Ardakaniz/BFComputer/architecture/architecture.jpg

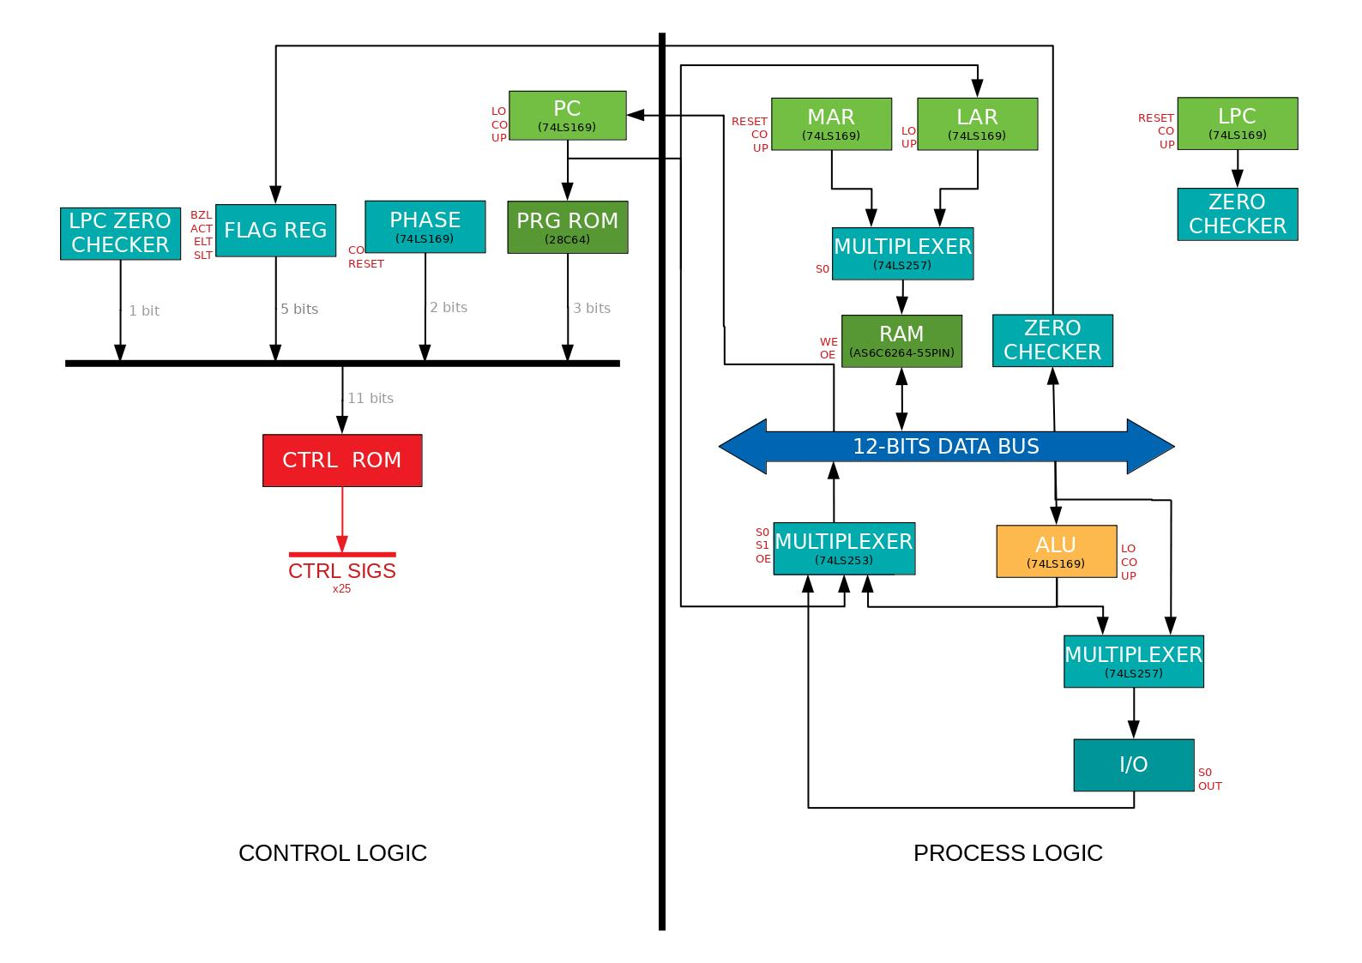
architecture/architecture.jpg
