Ardakaniz/BFComputer/architecture/BOM.ods

BFCom | Composant | Ref. composant | Site d’achat | Nombre | Prix unitaire | Prix total
 | Oscillateur 4MHz | SG-531P 4.0000MC | Mouser | 1 | 1,94 € | 1,94 € | Prix total : | 52,30 €
 | Oscillateur 10MHz | SG-531P 10.0000MC | Mouser | 1 | 1,94 € | 1,94 €
 | ROM 8k x 8 | 28C64 | Mouser | 8 | 2,81 € | 22,48 €
 | RAM 8k x 8 | AS6C6264-55PIN | Mouser | 4 | 2,50 € | 10,00 €
 | Timer 555 | NE555 | Mouser | 2 | 0,47 € | 0,94 €
 | Breadbord ? |  |  | 1 | 15,00 € | 15,00 €
 |  |  |  |  |  | 0,00 €
 |  |  |  |  |  | 0,00 €
 |  |  |  |  |  | 0,00 €
 |  |  |  |  |  | 0,00 €
 |  |  |  |  |  | 0,00 €
 |  |  |  |  |  | 0,00 €
 |  |  |  |  |  | 0,00 €
 |  |  |  |  |  | 0,00 €
 |  |  |  |  |  | 0,00 €
 |  |  |  |  |  | 0,00 €
 |  |  |  |  |  | 0,00 €
 |  |  |  |  |  | 0,00 €
 |  |  |  |  |  | 0,00 €
 |  |  |  |  |  | 0,00 €
 |  |  |  |  |  | 0,00 €
 |  |  |  |  |  | 0,00 €
 |  |  |  |  |  | 0,00 €
 |  |  |  |  |  | 0,00 €
 |  |  |  |  |  | 0,00 €
 |  |  |  |  |  | 0,00 €
 |  |  |  |  |  | 0,00 €
 |  |  |  |  |  | 0,00 €
 |  |  |  |  |  | 0,00 €
 |  |  |  |  |  | 0,00 €
 |  |  |  |  |  | 0,00 €
 |  |  |  |  |  | 0,00 €
 |  |  |  |  |  | 0,00 €
 |  |  |  |  |  | 0,00 €
 |  |  |  |  |  | 0,00 €
 |  |  |  |  |  | 0,00 €
 |  |  |  |  |  | 0,00 €
 |  |  |  |  |  | 0,00 €
 |  |  |  |  |  | 0,00 €
 |  |  |  |  |  | 0,00 €
 |  |  |  |  |  | 0,00 €
 |  |  |  |  |  | 0,00 €
 |  |  |  |  |  | 0,00 €
 |  |  |  |  |  | 0,00 €
 |  |  |  |  |  | 0,00 €
 |  |  |  |  |  | 0,00 €
 |  |  |  |  |  | 0,00 €
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
 |  |  |  |  |  | 0,00 €
 |  |  |  |  |  | 0,00 €
 |  |  |  |  |  | 0,00 €
 |  |  |  |  |  | 0,00 €
 |  |  |  |  |  | 0,00 €
 |  |  |  |  |  | 0,00 €
 |  |  |  |  |  | 0,00 €
 |  |  |  |  |  | 0,00 €
 |  |  |  |  |  | 0,00 €
 |  |  |  |  |  | 0,00 €
 |  |  |  |  |  | 0,00 €
