Ardakaniz/BFComputer/architecture/schematic.pdf

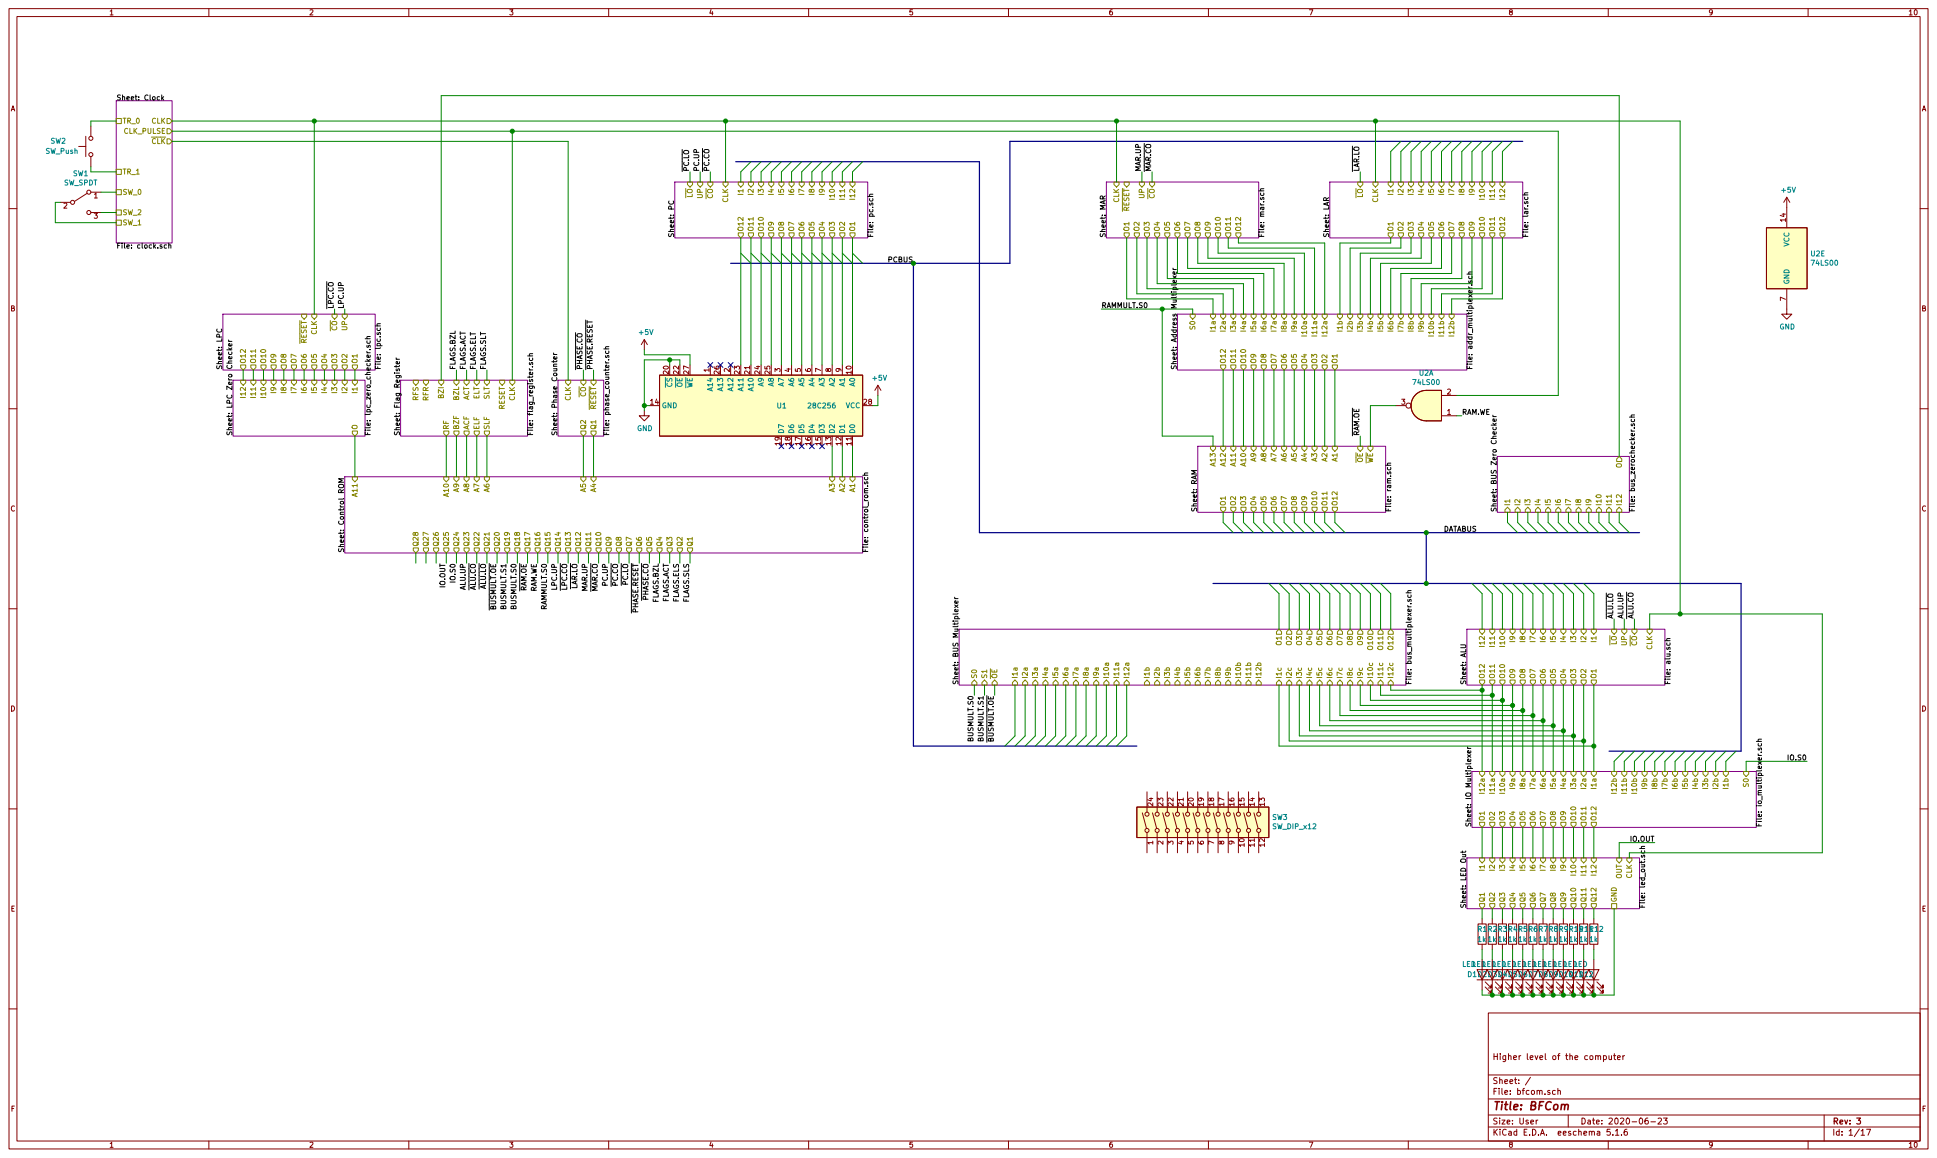
[picture p2: page 1]

2 CS 20 A10 21 OE 22 A11 23 A9 24 A8 25 A13 26 WE 27 VCC 28 A7

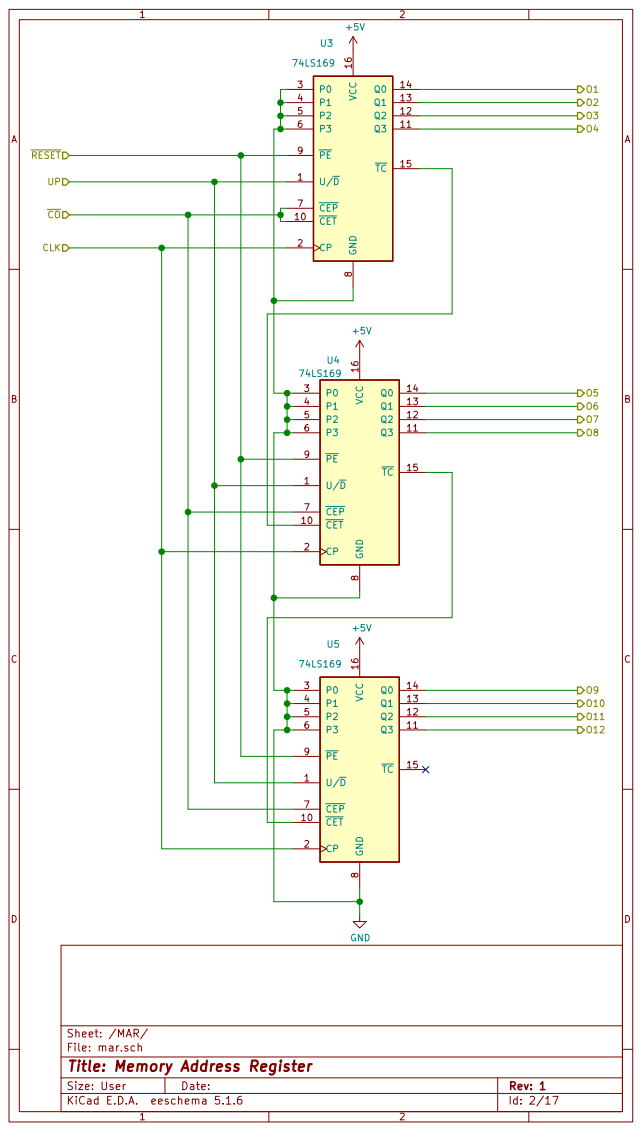
[picture p3: page 2]

Id: 2/17 Title: Memory Address Register File: mar.sch Sheet: /MAR/

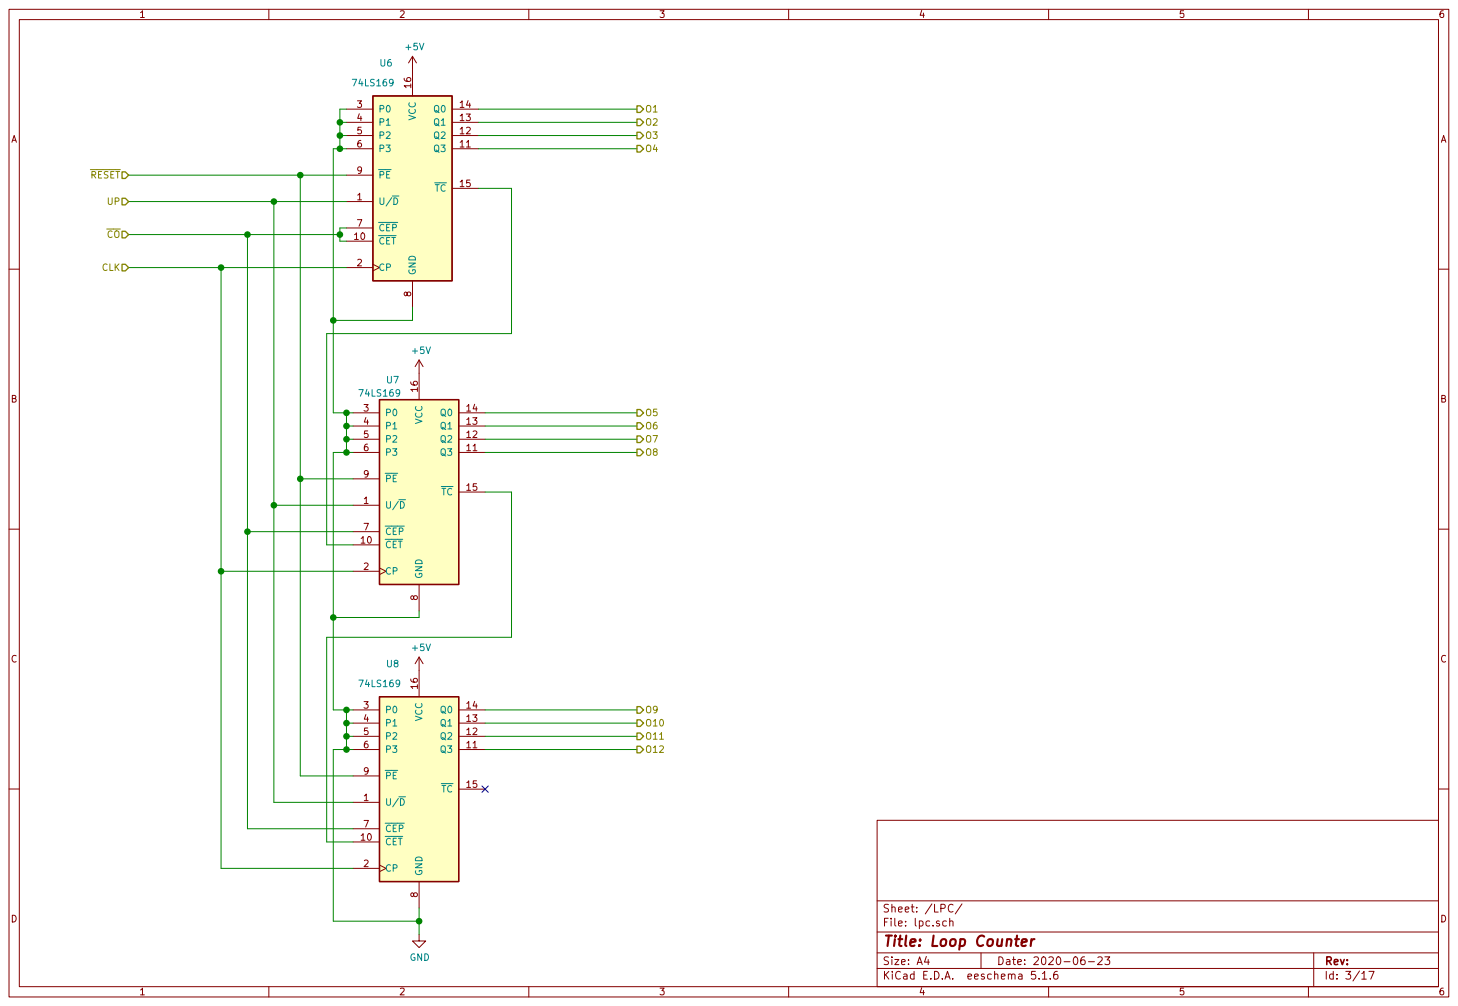
[picture p4: page 3]

Id: 3/17 Title: Loop Counter

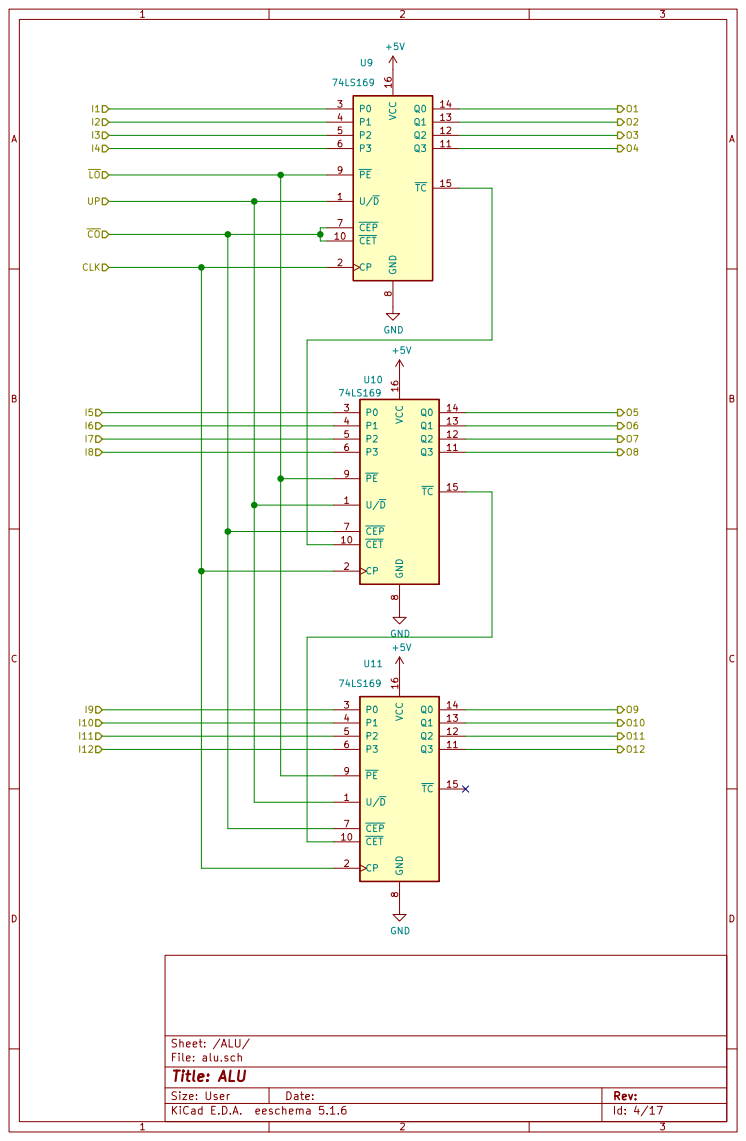
[picture p5: page 4]

File: alu.sch Sheet: /ALU/
Id: 4/17 Title: ALU

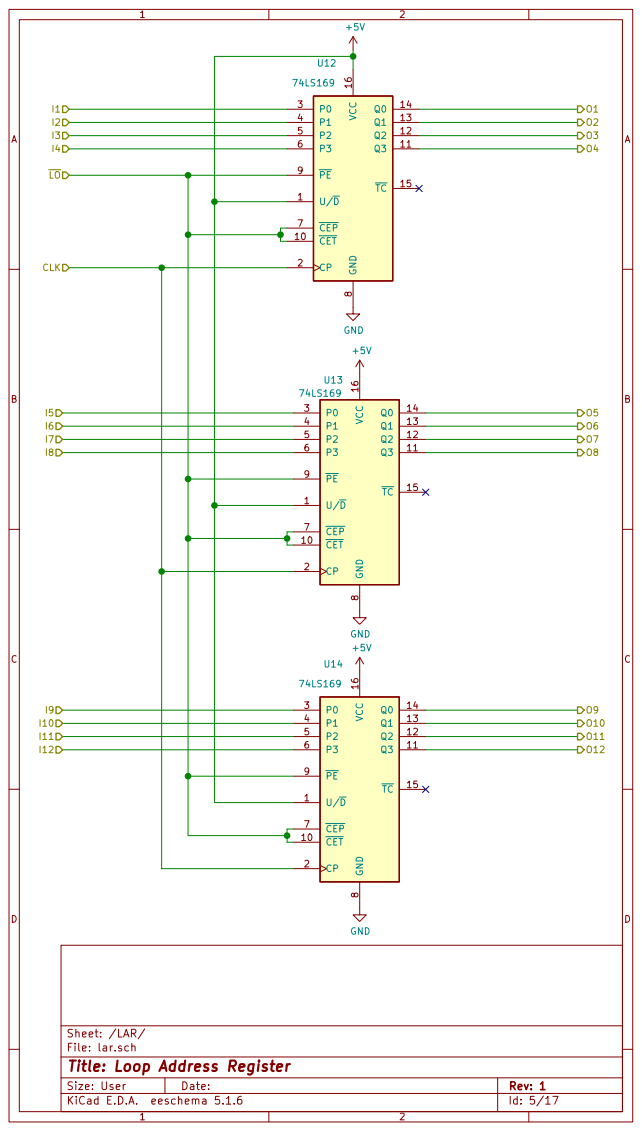
[picture p6: page 5]

Id: 5/17 Title: Loop Address Register File: lar.sch Sheet: /LAR/

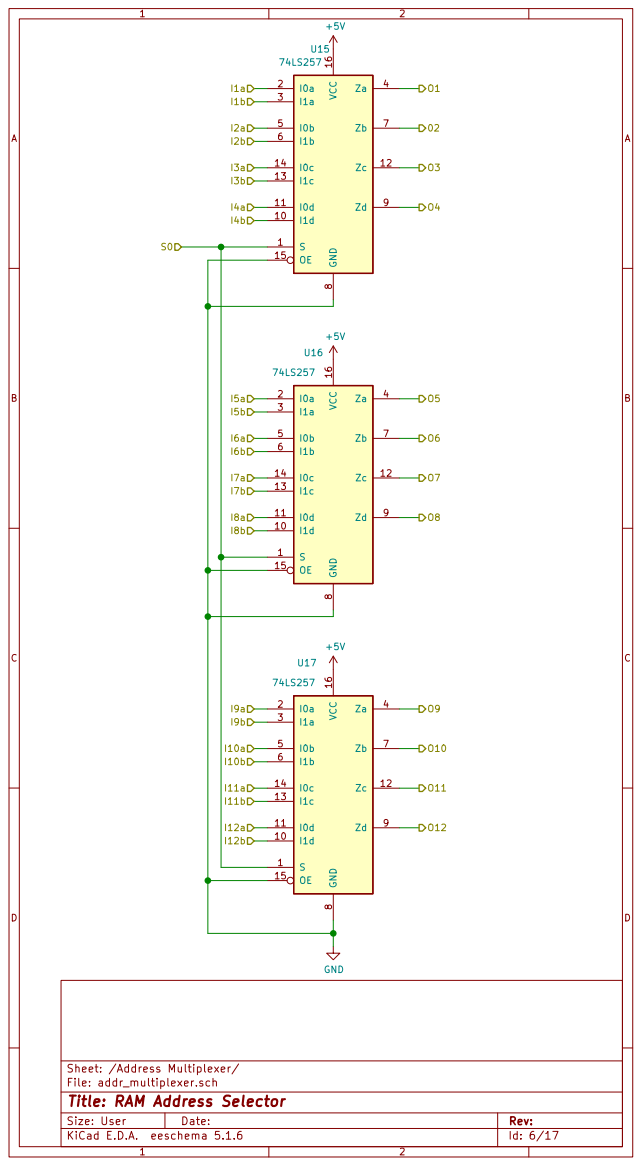
[picture p7: page 6]

Sheet: /Address Multiplexer/
File: addr_multiplexer.sch
Id: 6/17 Title: RAM Address Selector

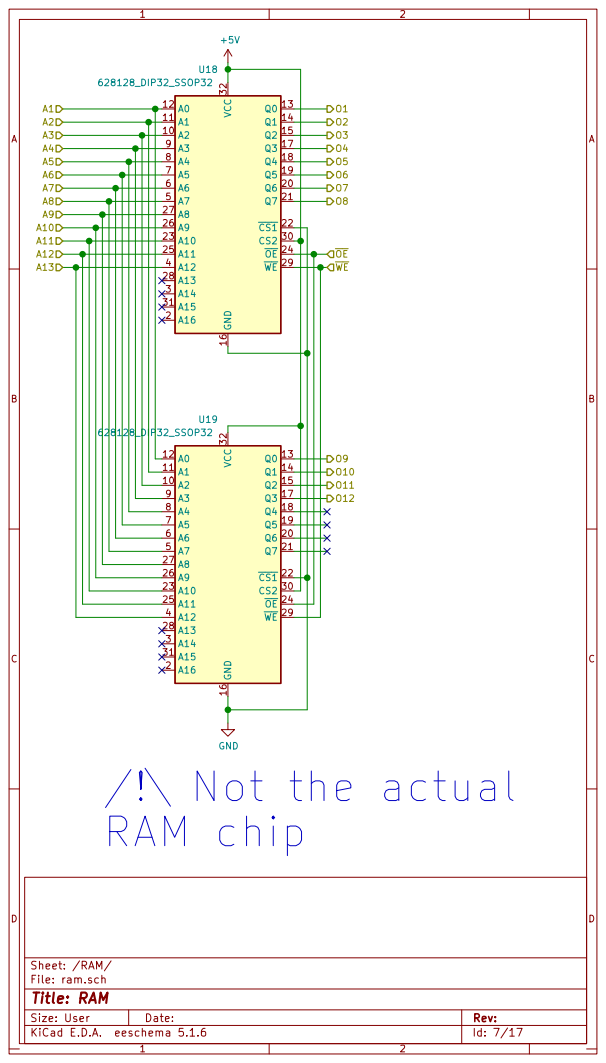
[picture p8: page 7]

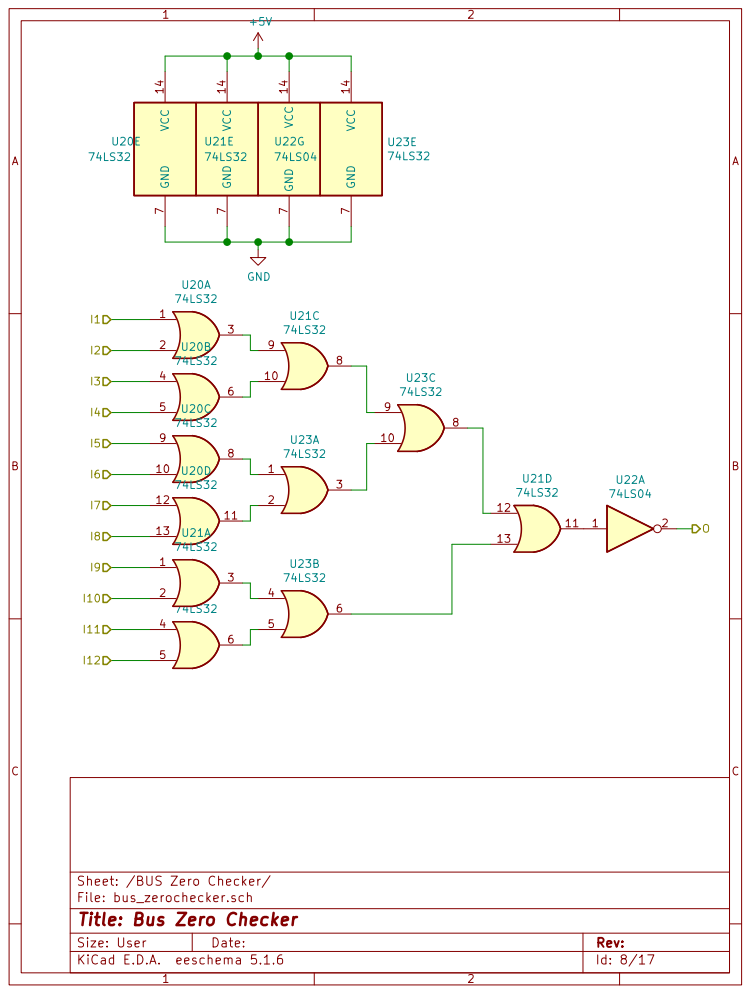
[picture p9: page 8]

File: bus_zerochecker.sch Sheet: /BUS Zero Checker/
Id: 8/17 Title: Bus Zero Checker

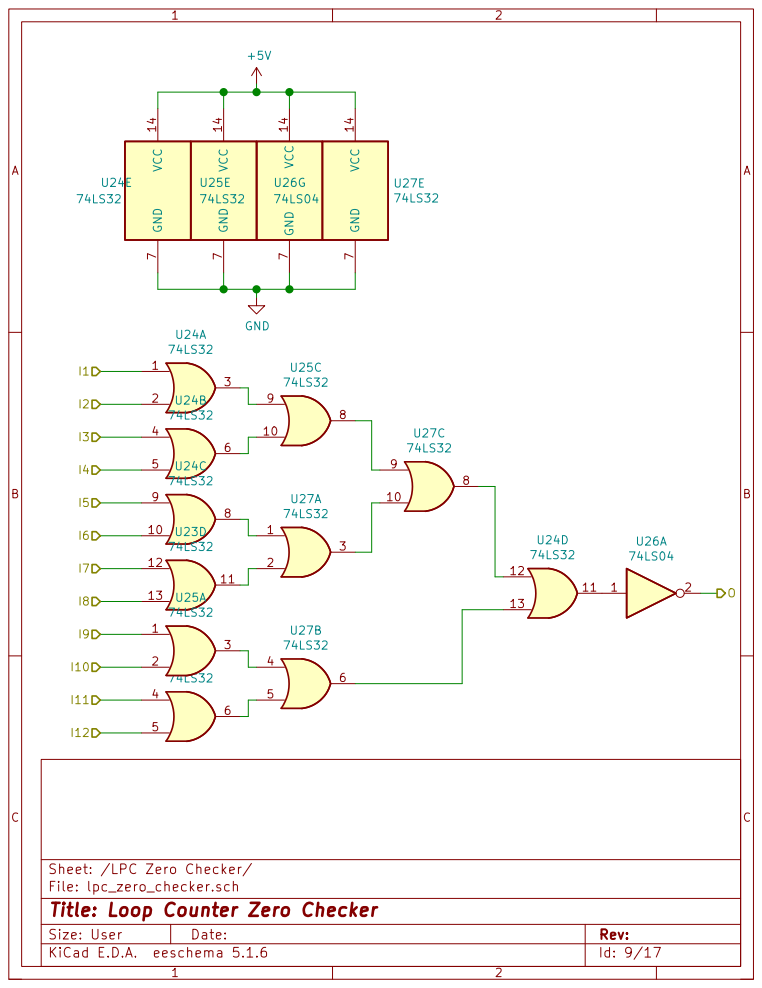
[picture p10: page 9]

File: lpc_zero_checker.sch Sheet: /LPC Zero Checker/
Id: 9/17 Title: Loop Counter Zero Checker

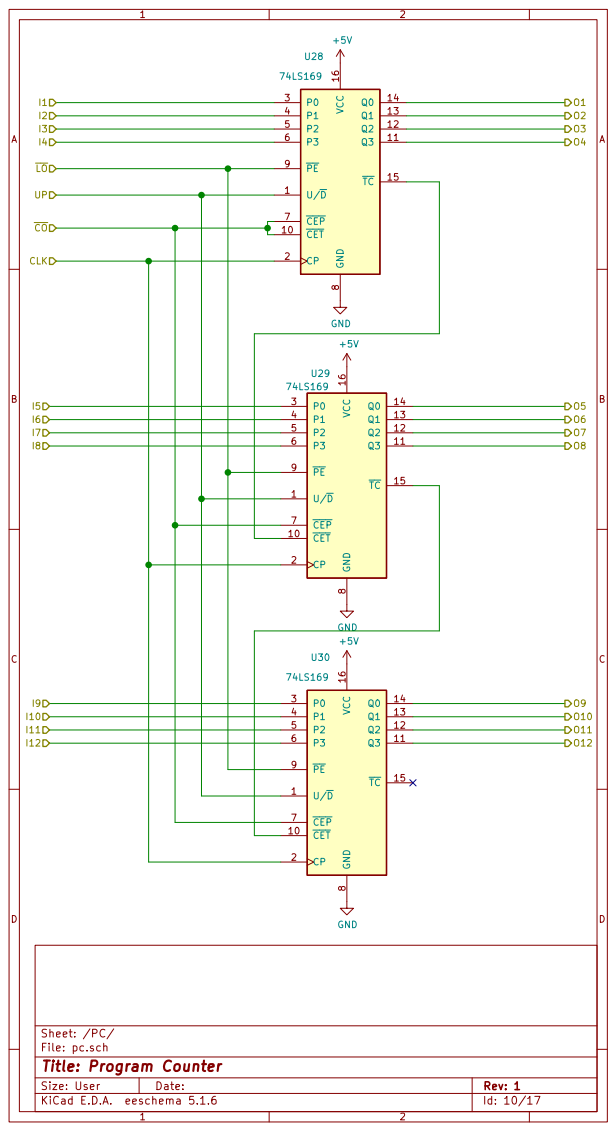
[picture p11: page 10]

File: pc.sch Sheet: /PC/
Id: 10/17 Title: Program Counter

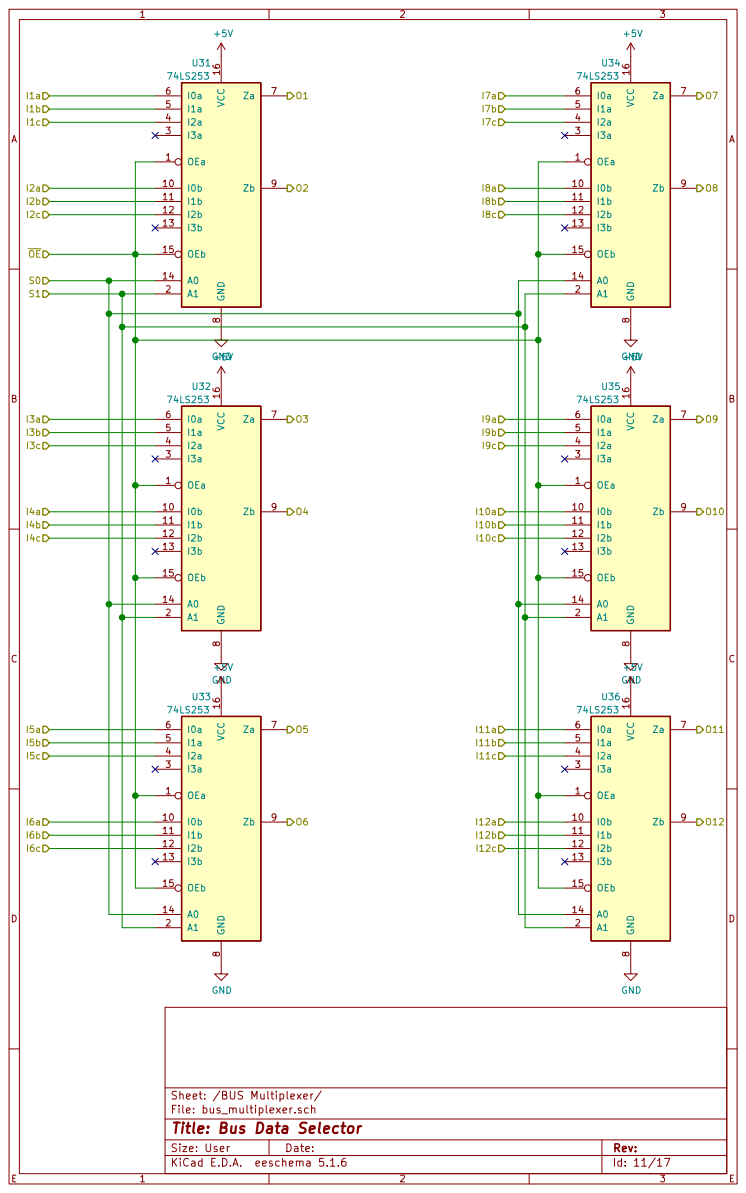
[picture p12: page 11]

Sheet: /BUS Multiplexer/
File: bus_multiplexer.sch
Id: 11/17 Title: Bus Data Selector

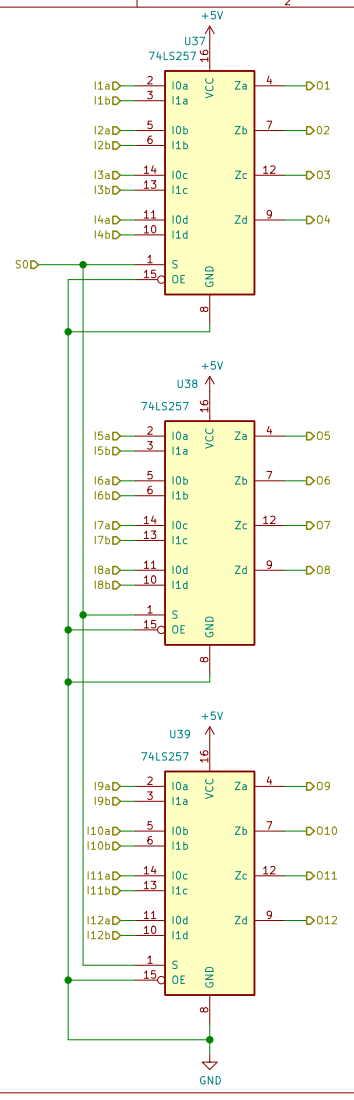
[picture p13: page 12]

Sheet: /IO Multiplexer/
File: io_multiplexer.sch
Id: 12/17 Title: Output Selector

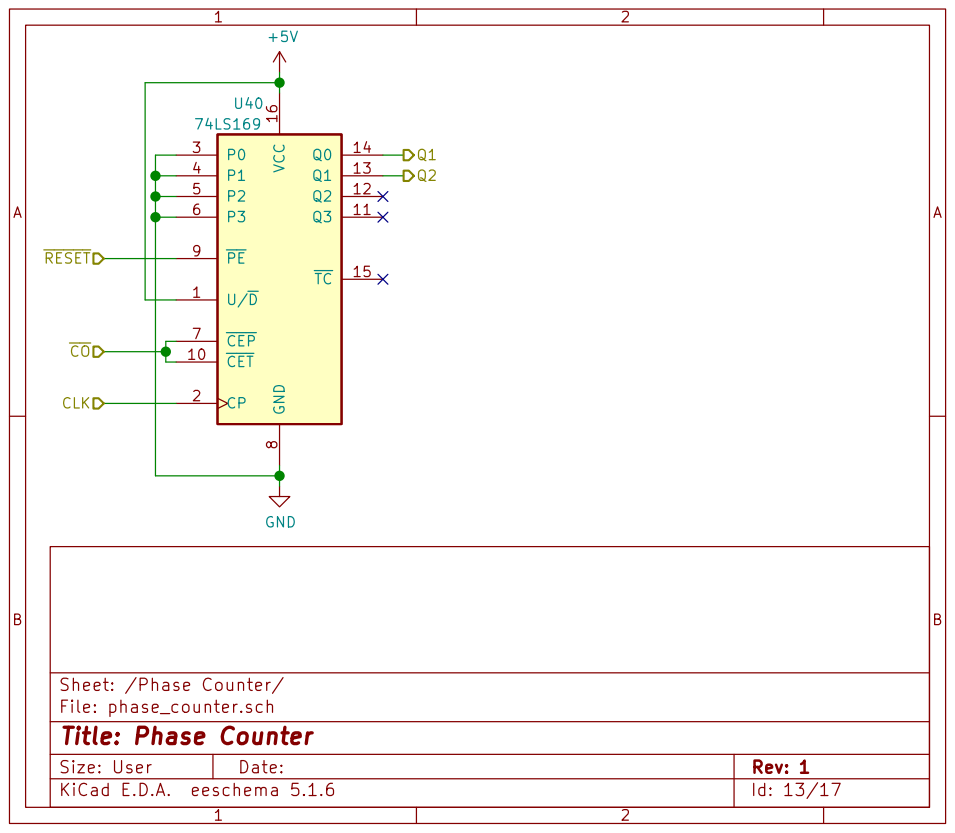
[picture p14: page 13]

File: phase_counter.sch Sheet: /Phase Counter/
Id: 13/17 Title: Phase Counter

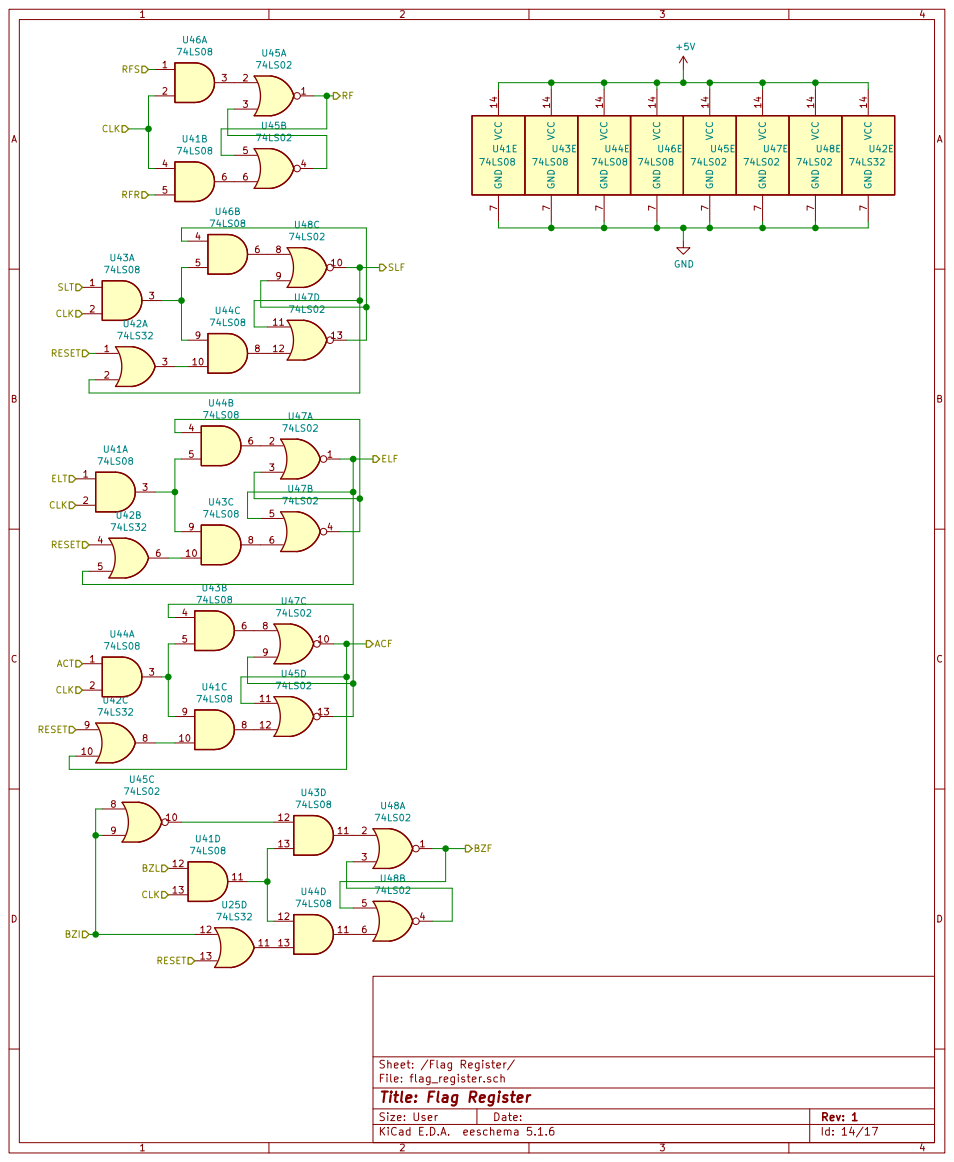
[picture p15: page 14]

Sheet: /Flag Register/
File: flag_register.sch
Id: 14/17 Title: Flag Register

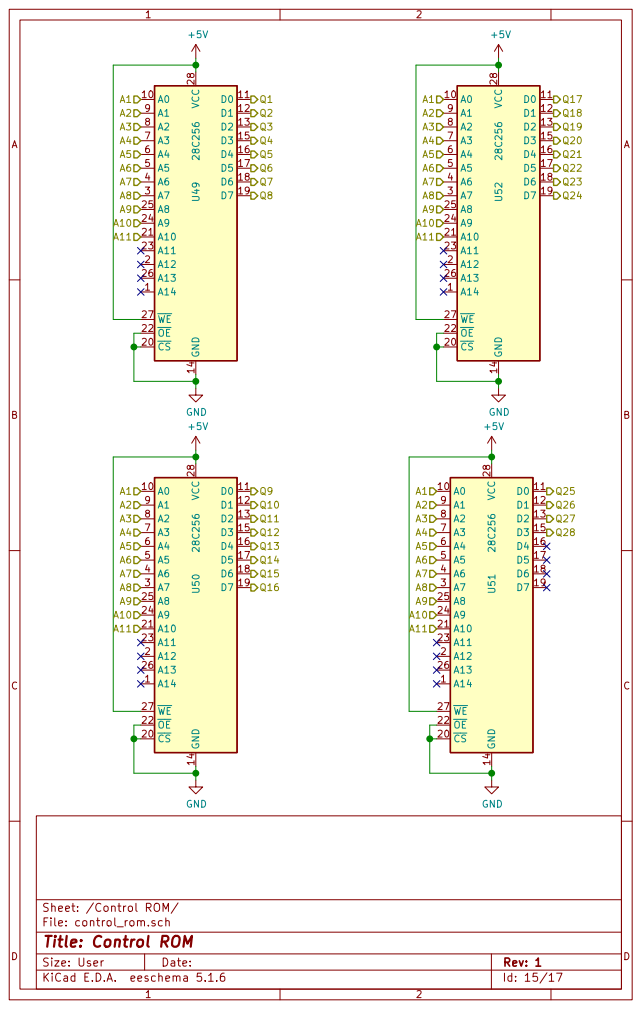
[picture p16: page 15]

Id: 15/17 Title: Control ROM

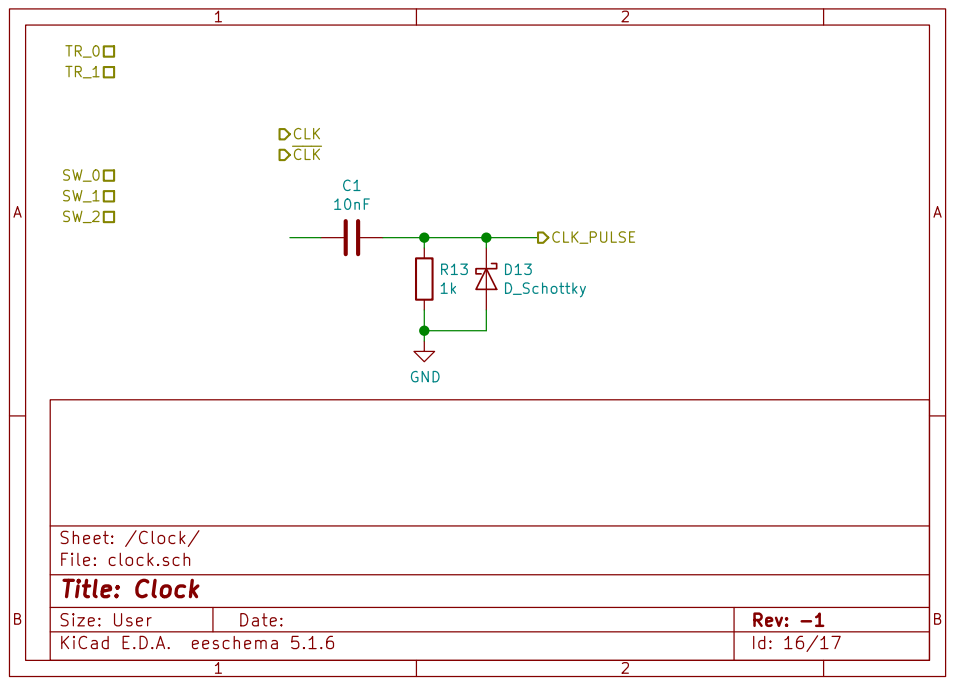
[picture p17: page 16]

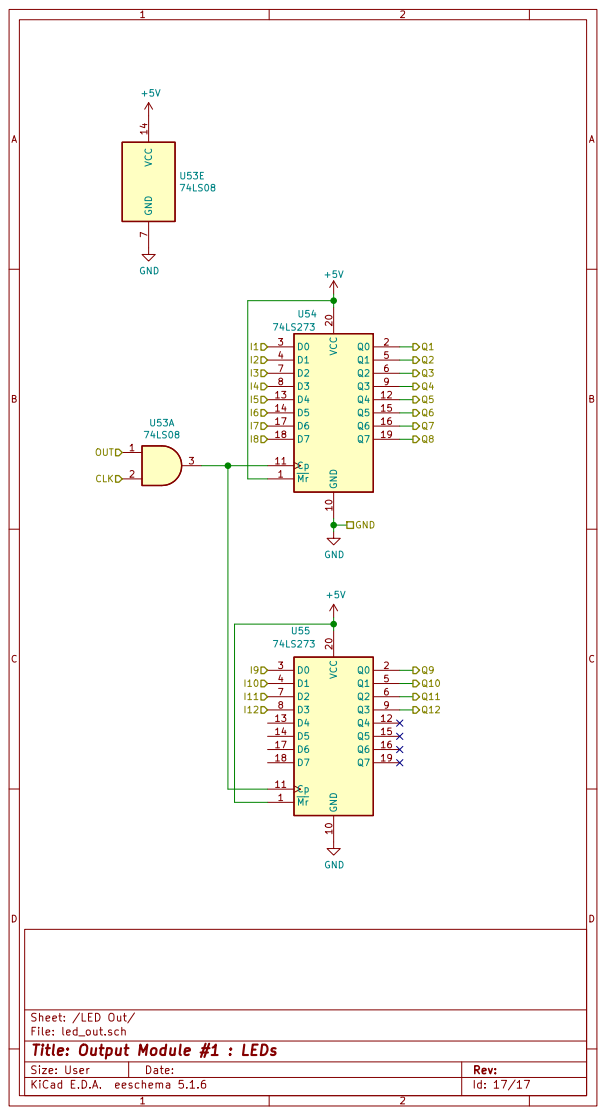
[picture p18: page 17]

Id: 17/17 Title: Output Module #1 : LEDs
