Ardakaniz/BFComputer/(list of files, drawings)

Other design files:
logisim/sim.circ
