Ardakaniz/BFComputer/(commit log)

2019-08-30 Architecture schematic now svg file
2019-08-30 Add beginning of BOM file
    [BOM.ods]
2020-06-23 Forgotten updates...
    * Add architecture principle + schematic
    * Add out of date BOM...
    * Remove datasheets
    * Add Python compiler script
    * Remove VM and add logisim files
    * ucode_generator -> microcode_gen: complete remake
    [BOM.ods, sim.circ]
2022-06-06 Remove logisim files
    [sim.circ]
2022-06-06 BF impl, missing loops, to beautify
    [control_logic.vhdl, reg.vhdl]
